vattern/grandiceps/README.md

Released under CC BY-SA 4.0 license
# grandiceps
grandiceps

QWERTY Layer
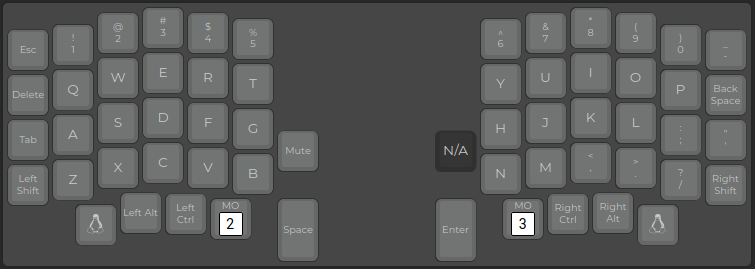
[picture p1: images/layer0.png]
layer0


ADJUST Layer
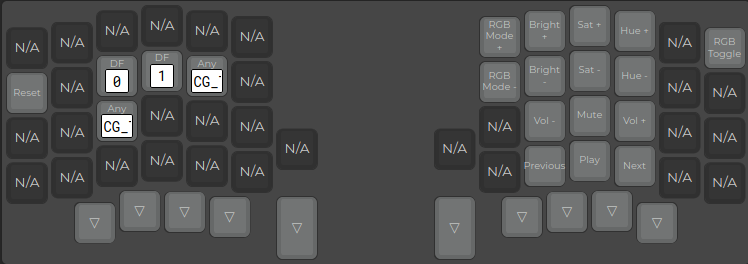
[picture p2: images/layer4.png]
layer4
