vattern/grandiceps/images/layer2.png

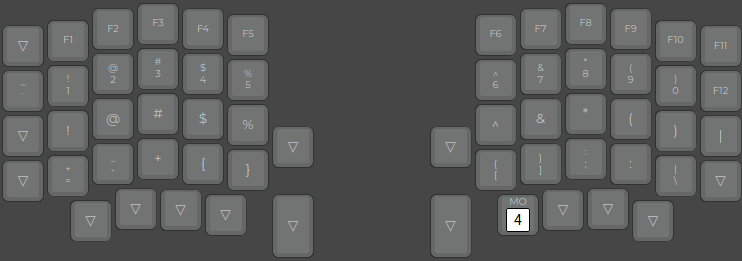
images/layer2.png
