vattern/grandiceps/images/layer3.png

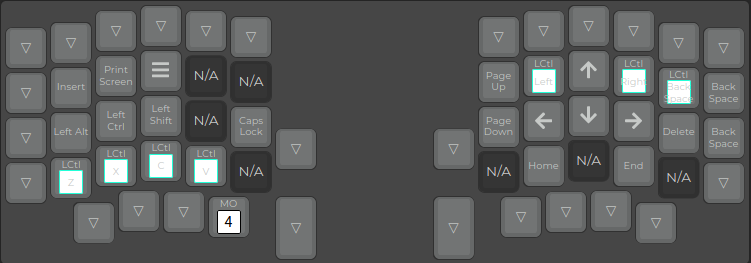
images/layer3.png
