vattern/grandiceps/case/grandiceps-plate.stl

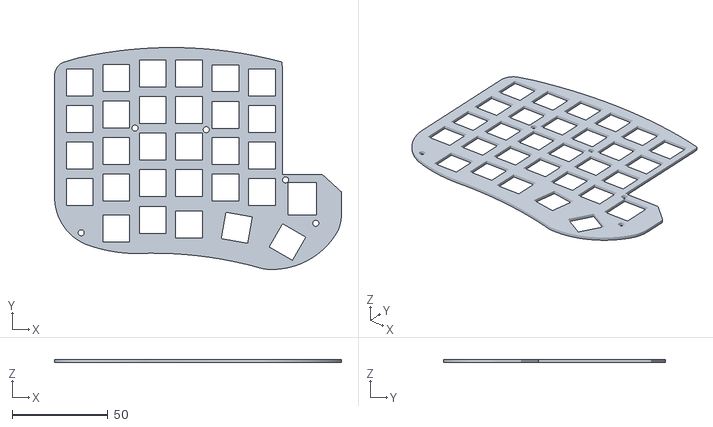
[picture p5: CAD file, 2021-03-13]
case/grandiceps-plate.stl
149.8 x 115.9 x 1.60
