vattern/grandiceps/case/grandiceps-case.stl

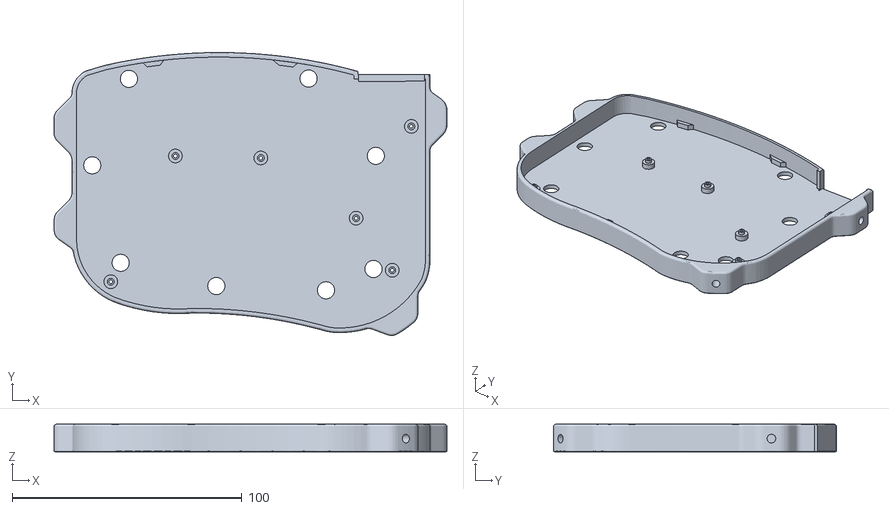
[picture p6: CAD file, 2021-03-13]
case/grandiceps-case.stl
171.0 x 123.1 x 12.0
