vattern/grandiceps/(threads)

Thread 1 (2022-04-17):

solder 10k resistor on one half or both halves?

yejianfengblue, 2022-04-17:
[buildguide](https://github.com/vattern/grandiceps/blob/master/BUILDGUIDE.md) says solder a 10k resistor on on half ( doesn't matter which half ) next to the TRRS Jack.

Should it be any one half or both halves?

vattern, 2022-05-24:
Only on the one half ( either will do )

Closed 2022-05-24.
