vattern/grandiceps/(commit log)

2021-01-29 Add initial files
    [#grandiceps-Edge_Cuts.dxf, autoleft.kicad_pcb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]
2021-02-16 Add plate rename rounded files
    [left1-rounded.kicad_pcb, plate.kicad_pcb, right-rounded.kicad_pcb]
2021-02-21 More gerbers
    [plate.kicad_pcb]
2021-02-21 Move folders around
    [bottom.kicad_pcb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]
2021-03-13 Add case files
    [grandiceps-case.stl, grandiceps-plate.stl]
2021-04-11 update bottom pcb
    [bottom-B_Cu.gbr, bottom-B_Mask.gbr, bottom-B_Silkscreen.gbr, bottom-Edge_Cuts.gbr, bottom-F_Cu.gbr, bottom-F_Mask.gbr, bottom-F_Silkscreen.gbr, bottom.drl]
